harshitkalra03/autonomous_warehouse_surveillance/Demo/Screenshot from 2025-11-26 17-15-10.png

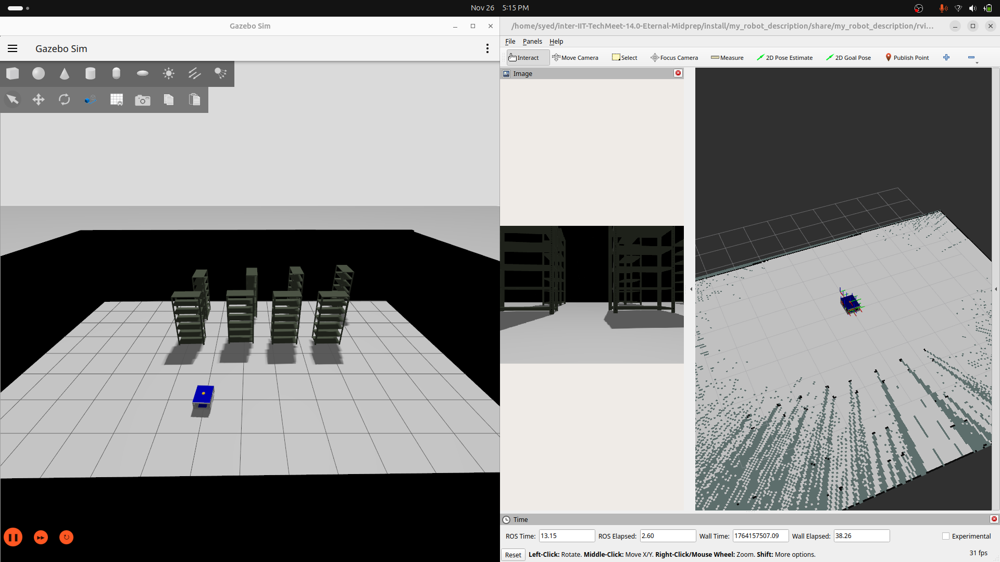
Demo/Screenshot from 2025-11-26 17-15-10.png
