harshitkalra03/autonomous_warehouse_surveillance/Demo/Screenshot from 2025-11-26 17-16-41.png

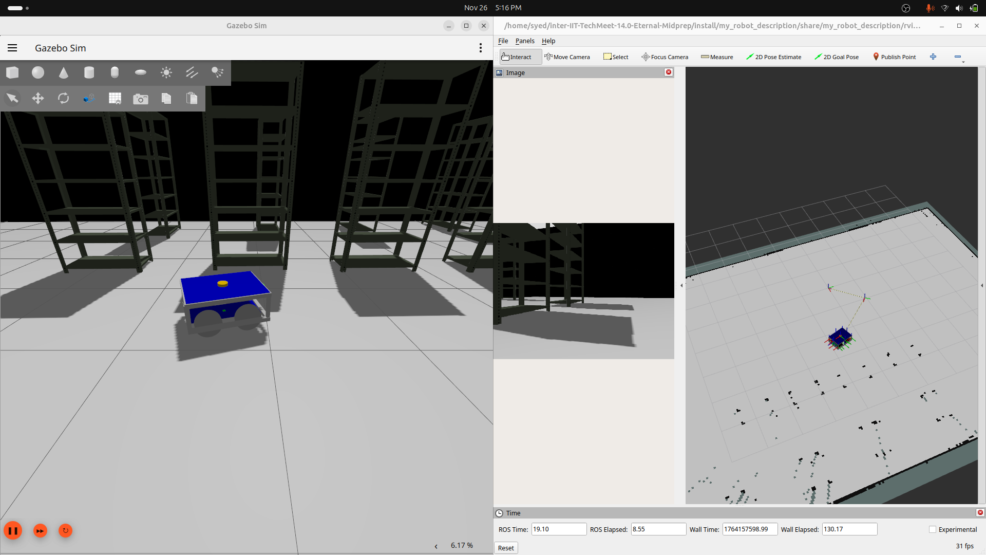
Demo/Screenshot from 2025-11-26 17-16-41.png
