harshitkalra03/autonomous_warehouse_surveillance/Electrical Schematics/Emergency Stop Circuit (Hard Wired).png

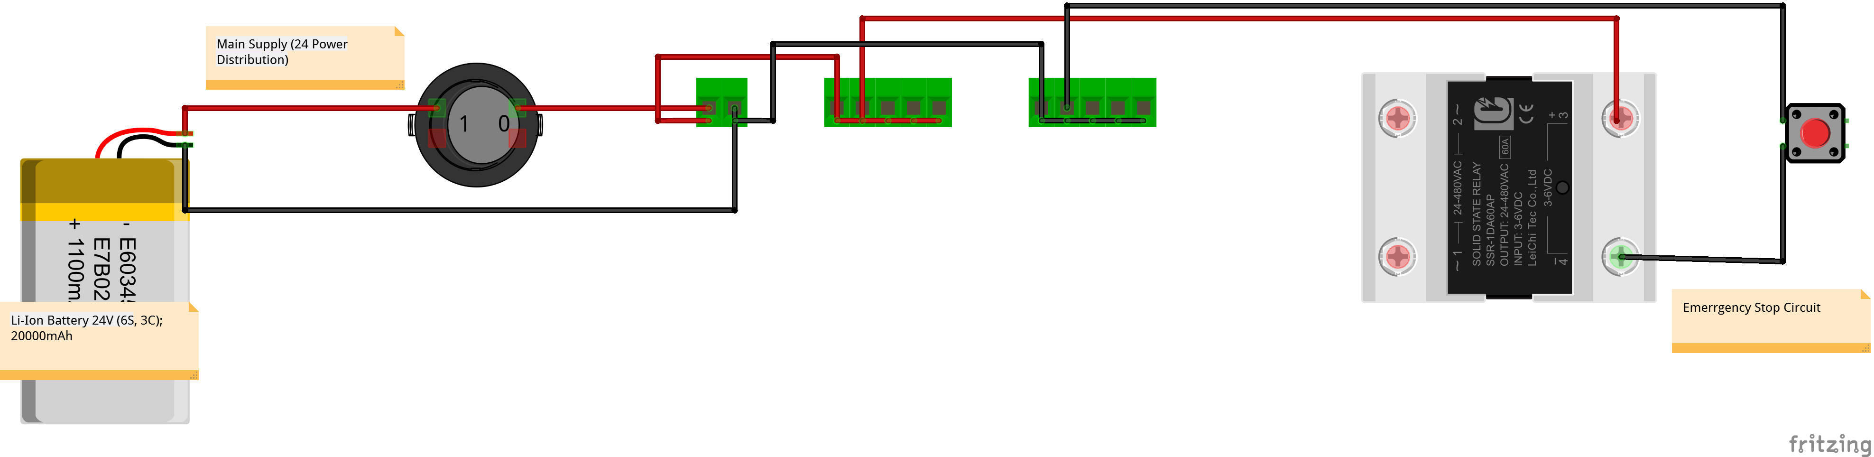
Electrical Schematics/Emergency Stop Circuit (Hard Wired).png
