harshitkalra03/autonomous_warehouse_surveillance/hardware/bot base.SLDASM

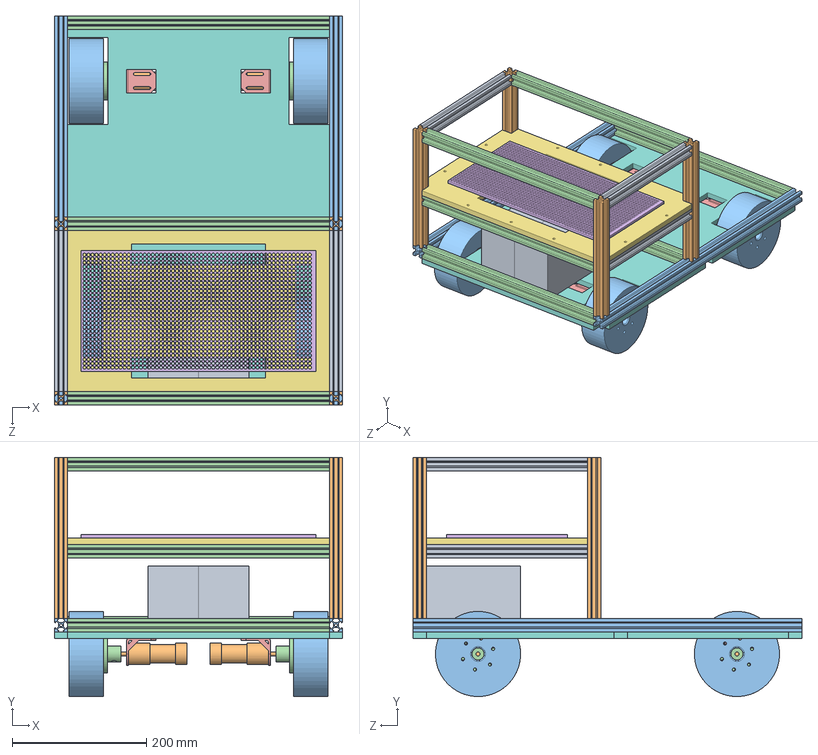
[picture p11: CAD file, 2026-06-30]
hardware/bot base.SLDASM
430.0 x 356.5 x 580.0 mm
layer 1 width x 7
layer 1 length x 2
layer 1 hight x 4
layer 2 length x 4
Sunboard
Vertical_Sunboard
Perfboard
Motor Mount_IG32 x 4
Wheel Mount_6mm x 4
Wheels x 4
IG32 Motor x 4
Battery x 2
