harshitkalra03/autonomous_warehouse_surveillance/hardware/bot base/wheel+motor.SLDASM

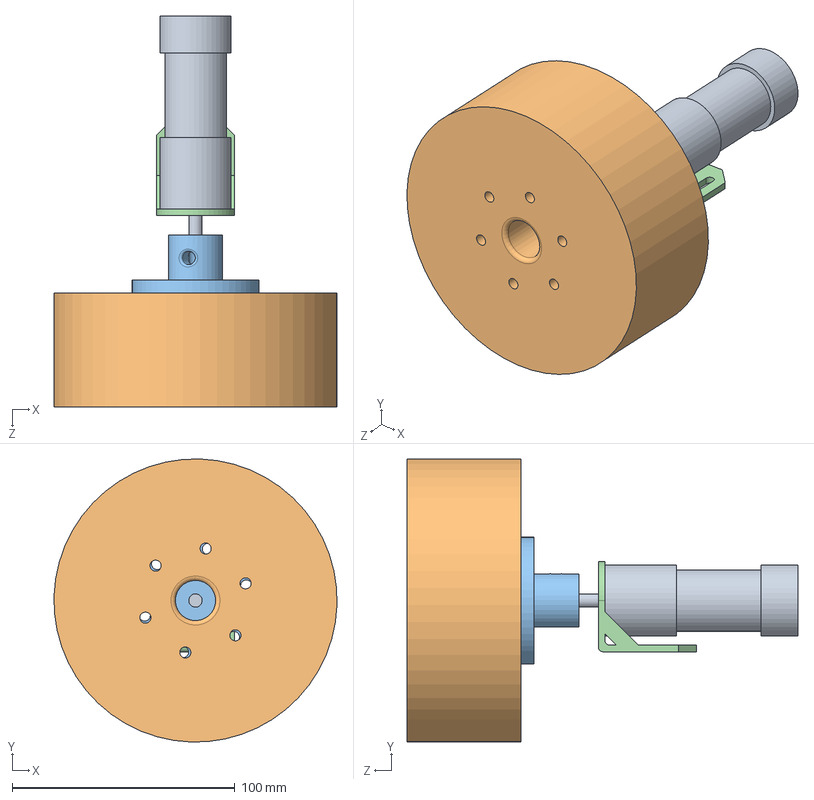
[picture p12: CAD file, 2026-06-30]
hardware/bot base/wheel+motor.SLDASM
126.9 x 126.9 x 175.3 mm
Motor Mount_IG32
Wheel Mount_6mm
Wheels
IG32 Motor
