harshitkalra03/autonomous_warehouse_surveillance/hardware/lifting mechanisum/mechanisum base/mechanisum base.SLDASM

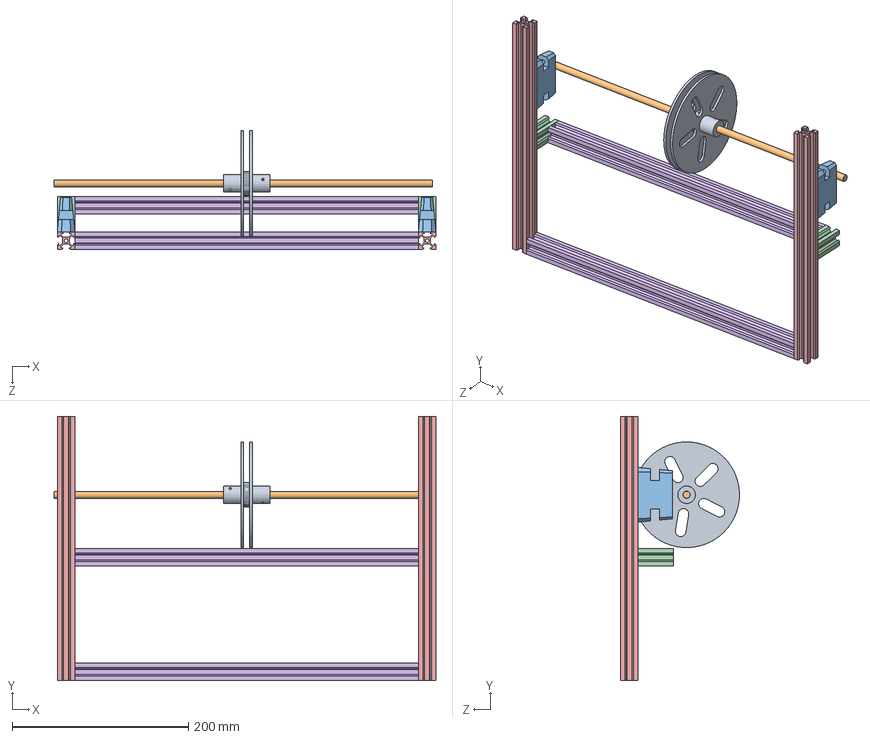
[picture p13: CAD file, 2026-06-30]
hardware/lifting mechanisum/mechanisum base/mechanisum base.SLDASM
433.7 x 300.0 x 135.0 mm
Aluminium Profile for width x 2
Aluminium Profile for length x 2
Aluminium Profile for hight x 2
bearing stand x 2
8mm shaft rod
winder side 1 x 2
