harshitkalra03/autonomous_warehouse_surveillance/hardware/lifting mechanisum/mechanisum/new camera mount.SLDASM

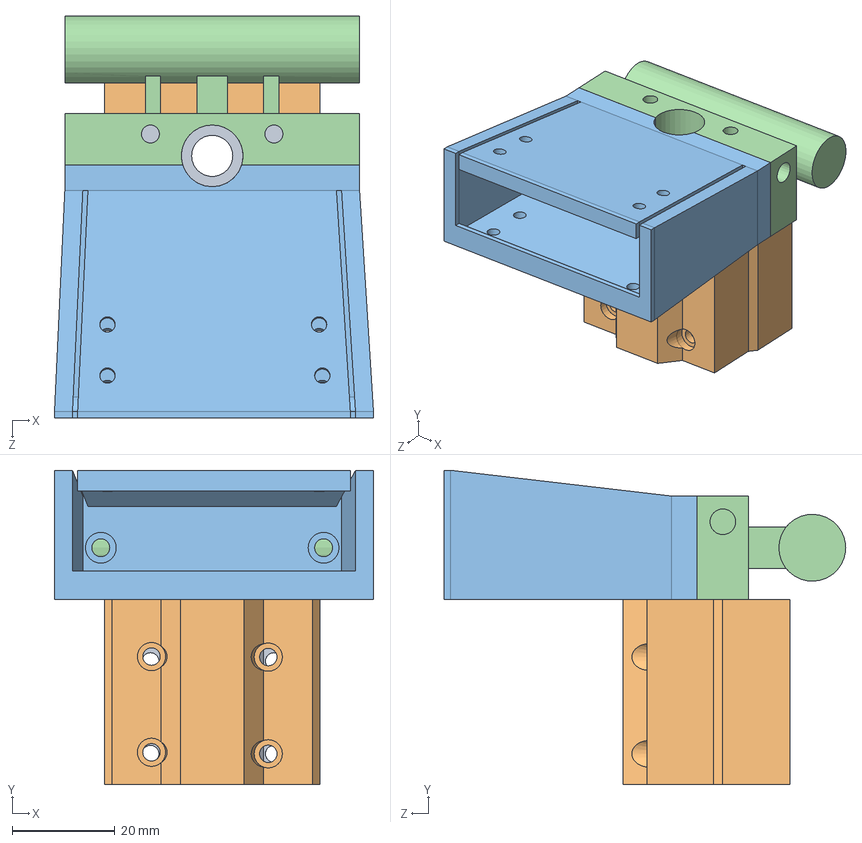
[picture p14: CAD file, 2026-06-30]
hardware/lifting mechanisum/mechanisum/new camera mount.SLDASM
62.0 x 61.1 x 78.0 mm
camera mount new part 2
camera mount new part 1
camera mount new part 3
vertical bearing
