harshitkalra03/autonomous_warehouse_surveillance/hardware/bot base/base/Sunboard.SLDPRT

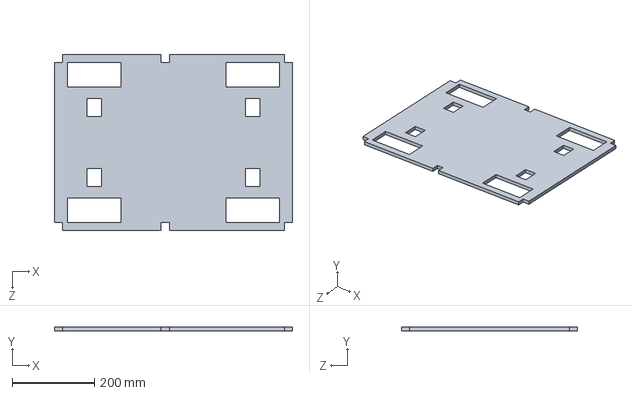
[picture p15: CAD file, 2026-06-30]
hardware/bot base/base/Sunboard.SLDPRT
580.0 x 10.0 x 430.0 mm
