harshitkalra03/autonomous_warehouse_surveillance/hardware/bot base/Battery.SLDPRT

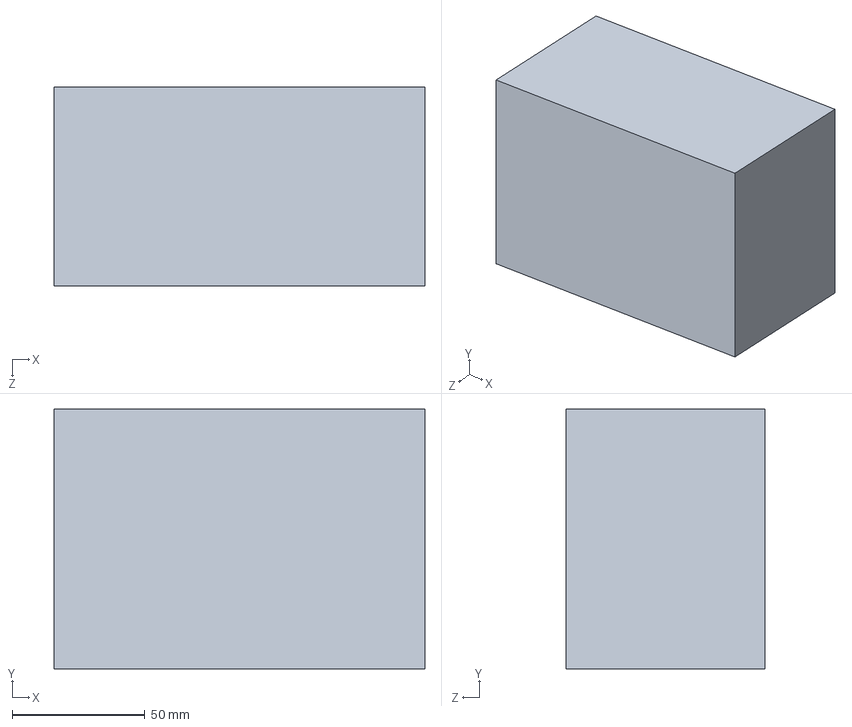
[picture p16: CAD file, 2026-06-30]
hardware/bot base/Battery.SLDPRT
140.0 x 98.0 x 75.0 mm
