harshitkalra03/autonomous_warehouse_surveillance/hardware/bot base/driving system/IG32 Motor.SLDPRT

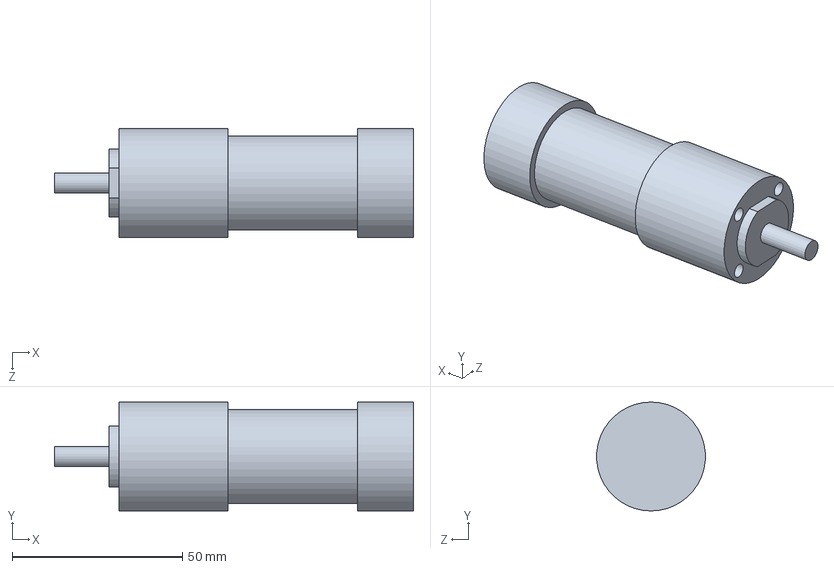
[picture p17: CAD file, 2026-06-30]
hardware/bot base/driving system/IG32 Motor.SLDPRT
105.5 x 32.0 x 31.9 mm
