harshitkalra03/autonomous_warehouse_surveillance/hardware/bot base/extrusion profile/layer 1 hight.SLDPRT

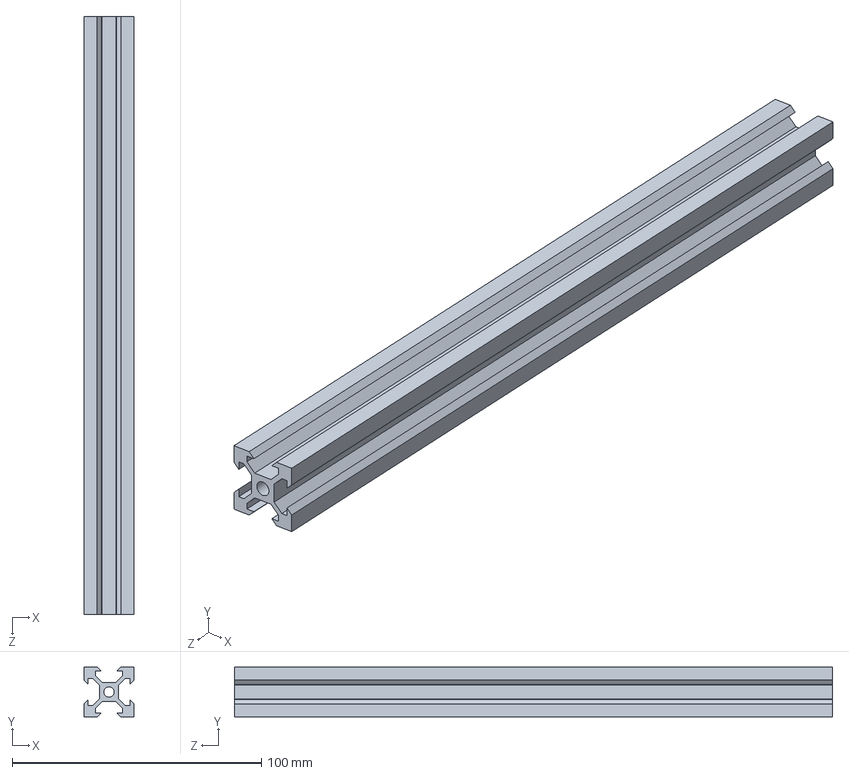
[picture p18: CAD file, 2026-06-30]
hardware/bot base/extrusion profile/layer 1 hight.SLDPRT
20.0 x 20.0 x 240.0 mm
