harshitkalra03/autonomous_warehouse_surveillance/hardware/lifting mechanisum/mechanisum base/bearing stand.SLDPRT

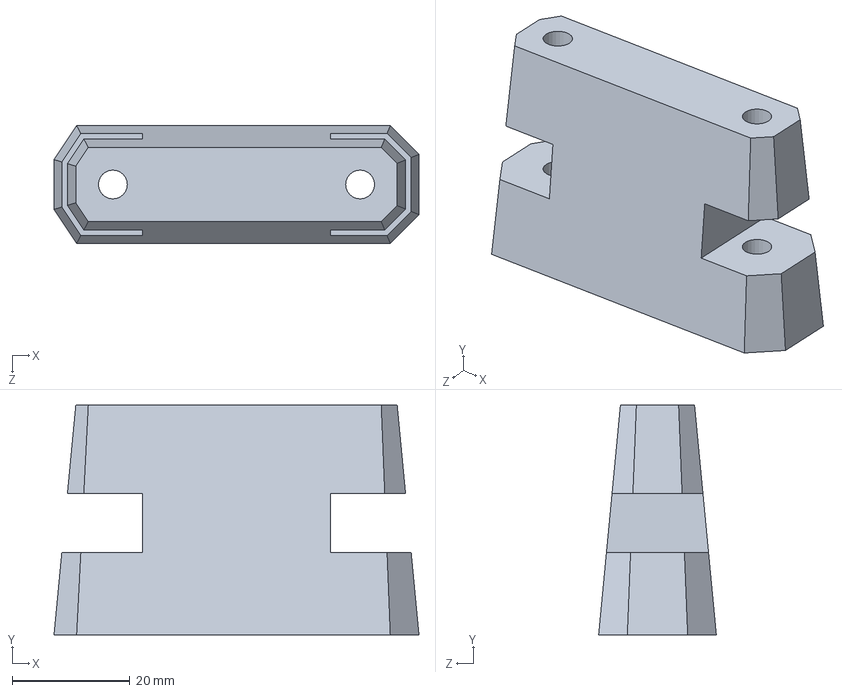
[picture p19: CAD file, 2026-06-30]
hardware/lifting mechanisum/mechanisum base/bearing stand.SLDPRT
62.0 x 39.0 x 20.0 mm
