harshitkalra03/autonomous_warehouse_surveillance/hardware/lifting mechanisum/mechanisum base/extrusion frame/Aluminium Profile for hight.SLDPRT

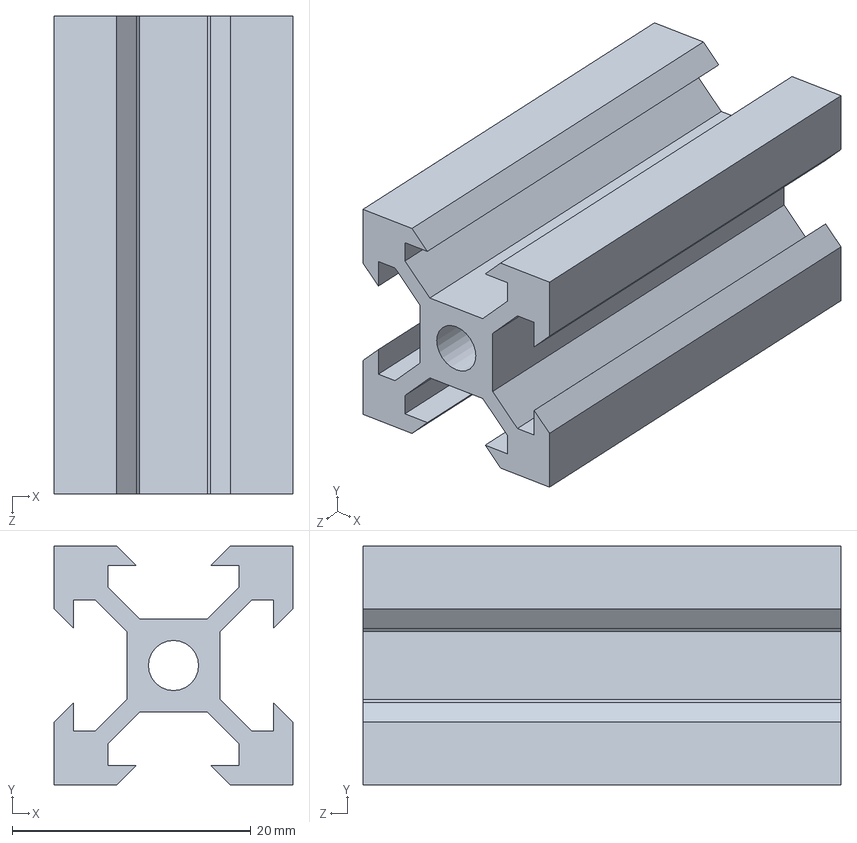
[picture p20: CAD file, 2026-06-30]
hardware/lifting mechanisum/mechanisum base/extrusion frame/Aluminium Profile for hight.SLDPRT
20.0 x 20.0 x 40.0 mm
