harshitkalra03/autonomous_warehouse_surveillance/hardware/lifting mechanisum/mechanisum/camera mount/camera mount new part 2.SLDPRT

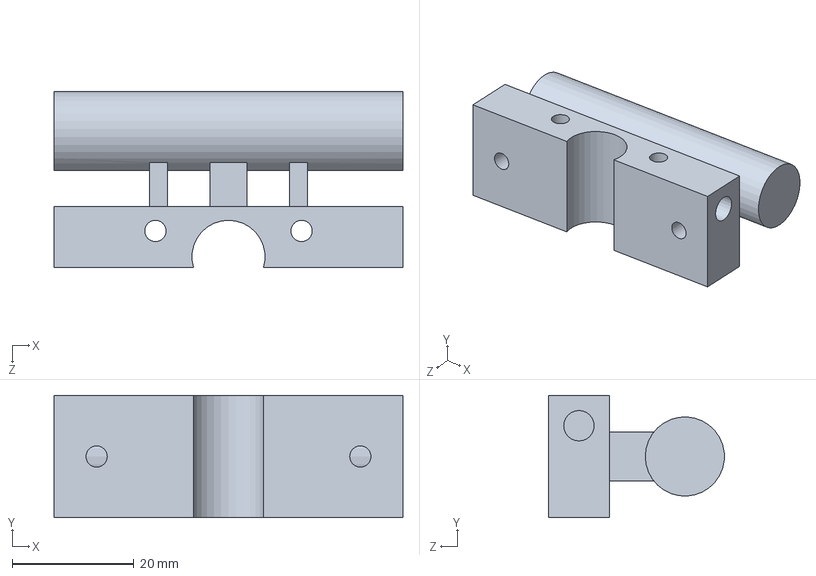
[picture p21: CAD file, 2026-06-30]
hardware/lifting mechanisum/mechanisum/camera mount/camera mount new part 2.SLDPRT
57.3 x 20.1 x 28.9 mm
