harshitkalra03/autonomous_warehouse_surveillance/hardware/lifting mechanisum/mechanisum/glider/bearing.SLDPRT

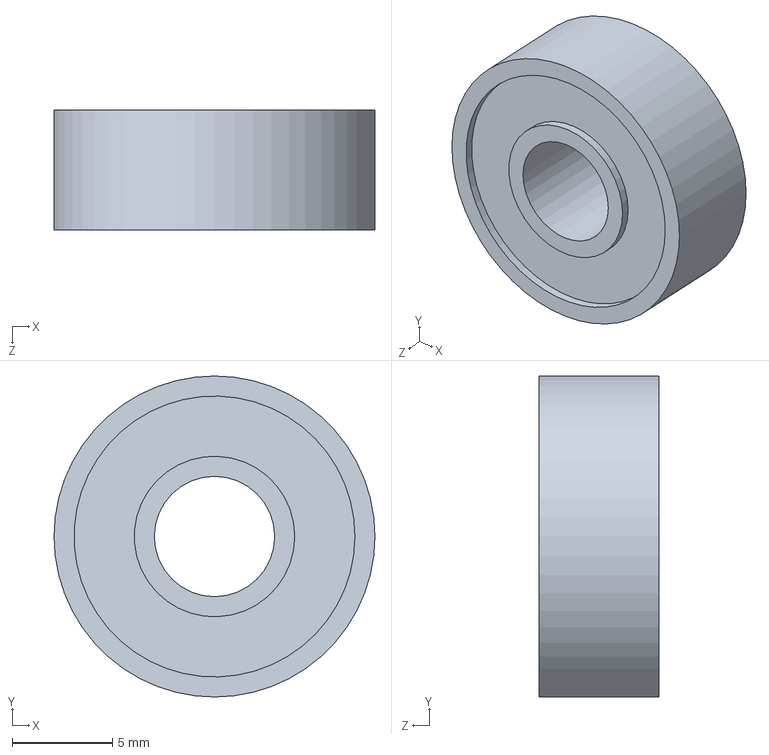
[picture p22: CAD file, 2026-06-30]
hardware/lifting mechanisum/mechanisum/glider/bearing.SLDPRT
16.0 x 16.0 x 6.00 mm
