harshitkalra03/autonomous_warehouse_surveillance/hardware/lifting mechanisum/mechanisum/rail setup/8mm crome plated rod.SLDPRT

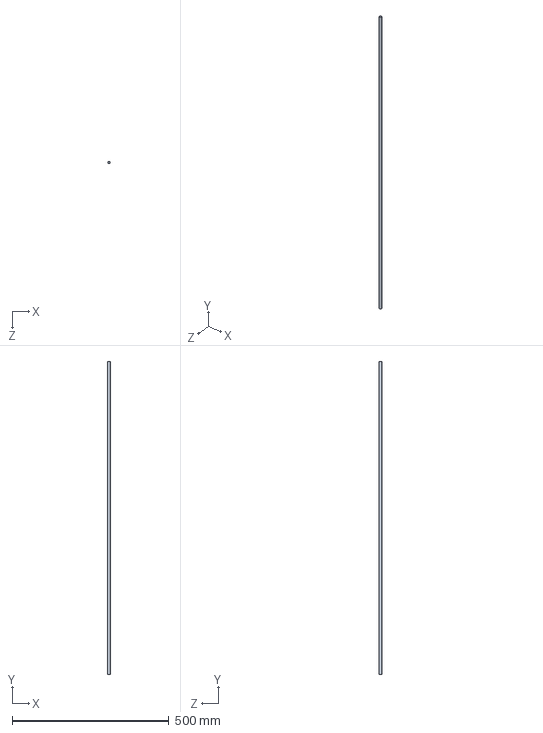
[picture p23: CAD file, 2026-06-30]
hardware/lifting mechanisum/mechanisum/rail setup/8mm crome plated rod.SLDPRT
8.00 x 1000.0 x 8.00 mm
