harshitkalra03/autonomous_warehouse_surveillance/hardware/mechanisum support.SLDPRT

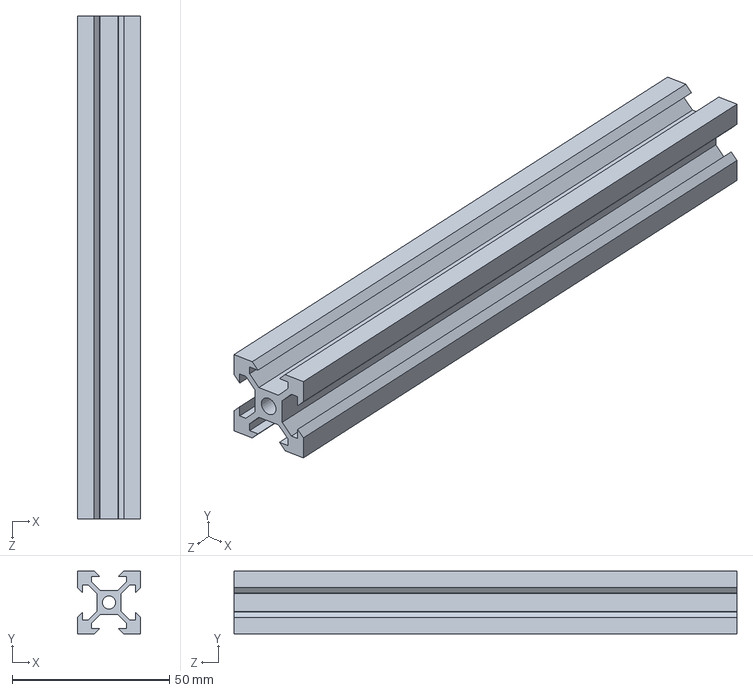
[picture p24: CAD file, 2026-06-30]
hardware/mechanisum support.SLDPRT
20.0 x 20.0 x 160.0 mm
