harshitkalra03/autonomous_warehouse_surveillance/hardware/bot base/base/Vertical_Sunboard.SLDPRT

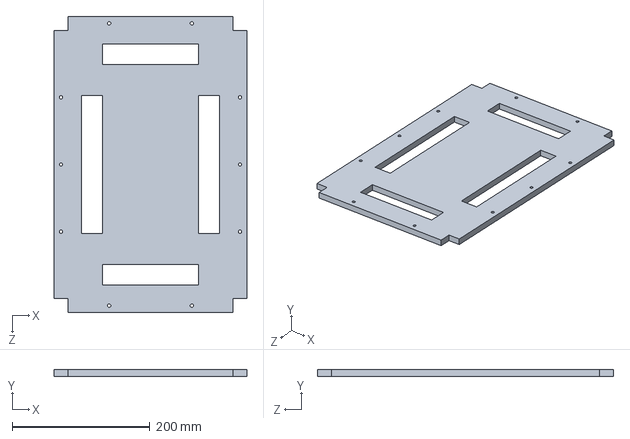
[picture p25: CAD file, 2026-06-30]
hardware/bot base/base/Vertical_Sunboard.SLDPRT
280.0 x 10.0 x 430.0 mm
