harshitkalra03/autonomous_warehouse_surveillance/hardware/bot base/driving system/Wheels.SLDPRT

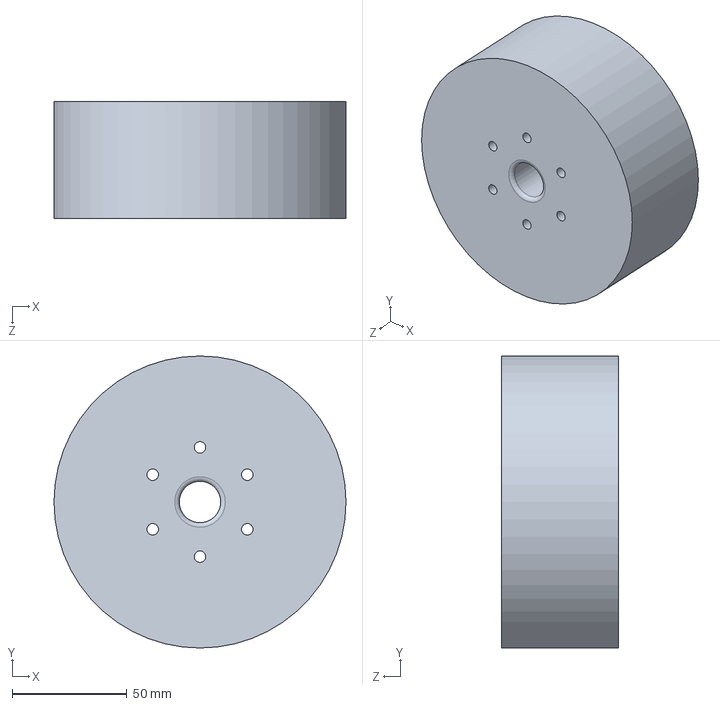
[picture p26: CAD file, 2026-06-30]
hardware/bot base/driving system/Wheels.SLDPRT
127.0 x 127.0 x 51.0 mm
