harshitkalra03/autonomous_warehouse_surveillance/hardware/bot base/extrusion profile/layer 1 width.SLDPRT

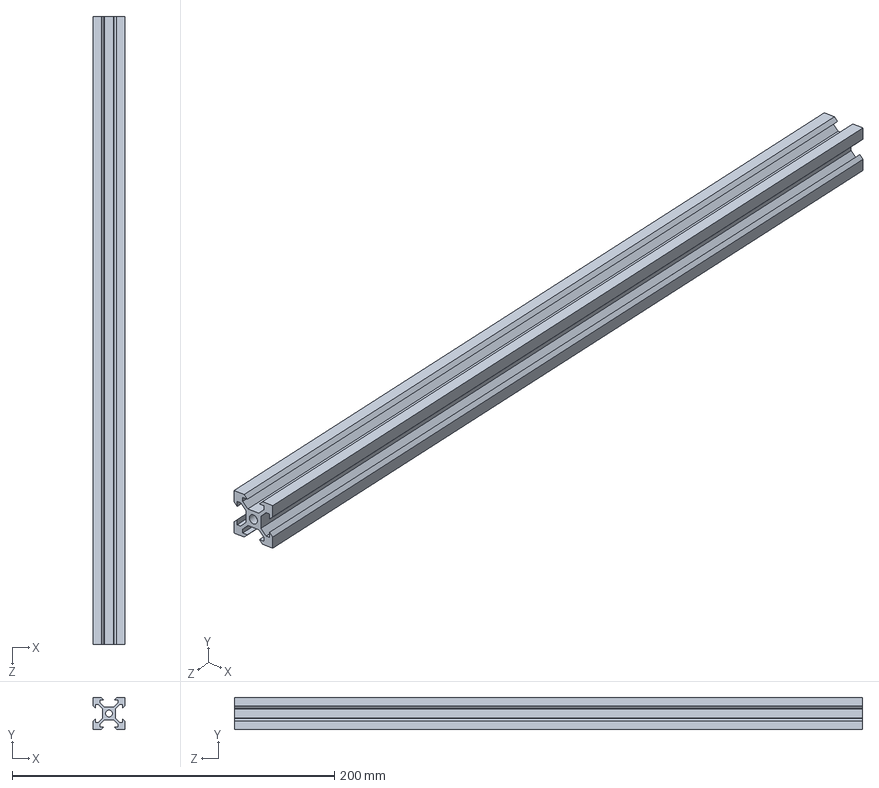
[picture p27: CAD file, 2026-06-30]
hardware/bot base/extrusion profile/layer 1 width.SLDPRT
20.0 x 20.0 x 390.0 mm
