harshitkalra03/autonomous_warehouse_surveillance/hardware/lifting mechanisum/mechanisum/camera mount/camera mount new part 3.SLDPRT

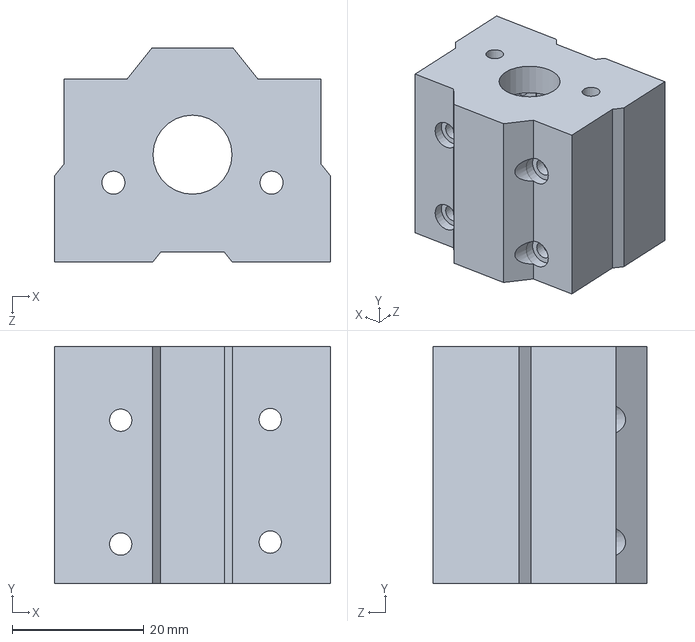
[picture p28: CAD file, 2026-06-30]
hardware/lifting mechanisum/mechanisum/camera mount/camera mount new part 3.SLDPRT
41.9 x 36.0 x 32.5 mm
