harshitkalra03/autonomous_warehouse_surveillance/hardware/lifting mechanisum/mechanisum/rail setup/rod Tube R8 holder.SLDPRT

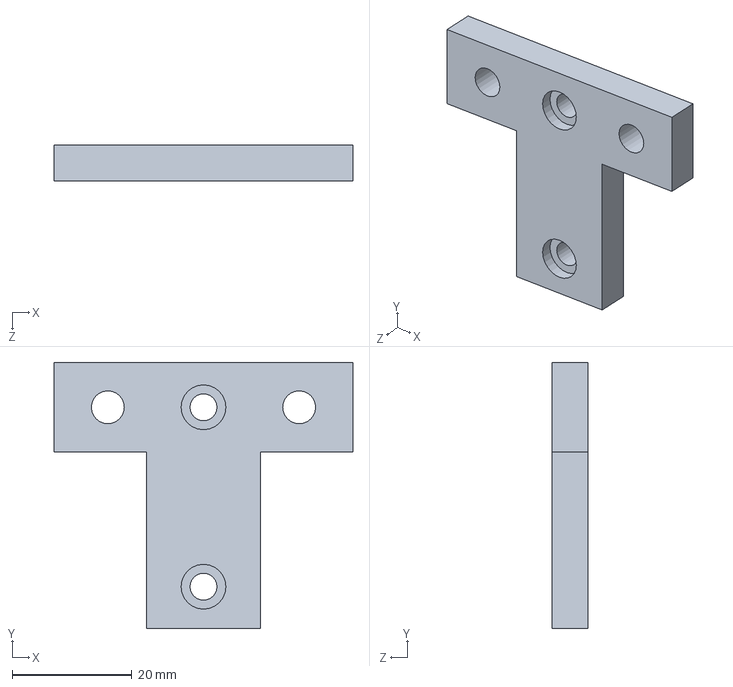
[picture p29: CAD file, 2026-06-30]
hardware/lifting mechanisum/mechanisum/rail setup/rod Tube R8 holder.SLDPRT
50.0 x 44.5 x 6.00 mm
