harshitkalra03/autonomous_warehouse_surveillance/hardware/bot base/base/Perfboard.SLDPRT

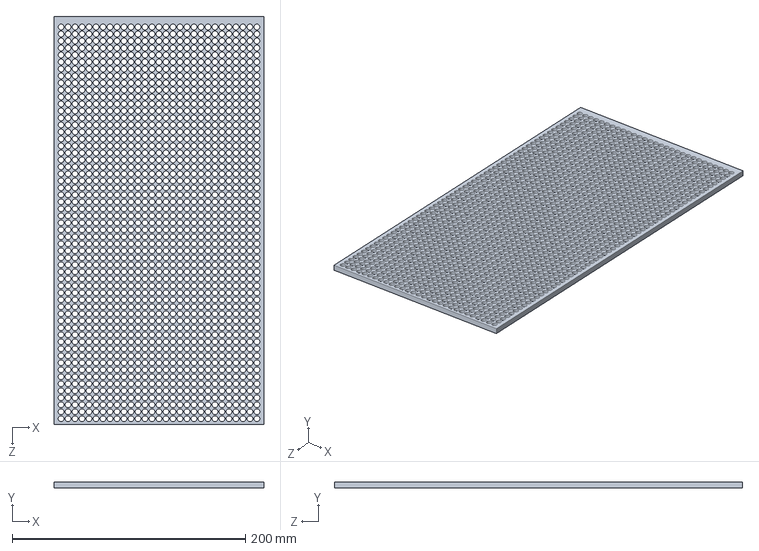
[picture p30: CAD file, 2026-06-30]
hardware/bot base/base/Perfboard.SLDPRT
180.0 x 5.00 x 350.0 mm
