harshitkalra03/autonomous_warehouse_surveillance/hardware/bot base/driving system/Motor Mount_IG32.SLDPRT

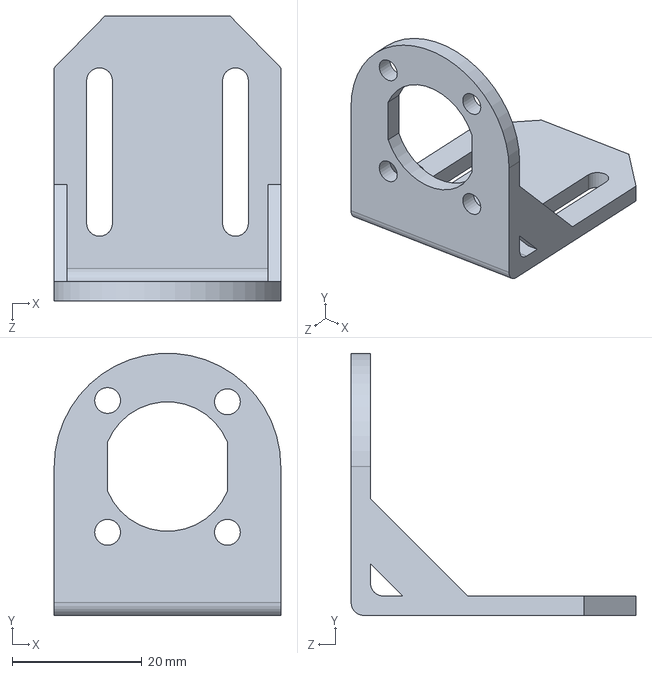
[picture p31: CAD file, 2026-06-30]
hardware/bot base/driving system/Motor Mount_IG32.SLDPRT
35.0 x 40.5 x 44.0 mm
