harshitkalra03/autonomous_warehouse_surveillance/hardware/lifting mechanisum/mechanisum base/extrusion frame/Aluminium Profile for length.SLDPRT

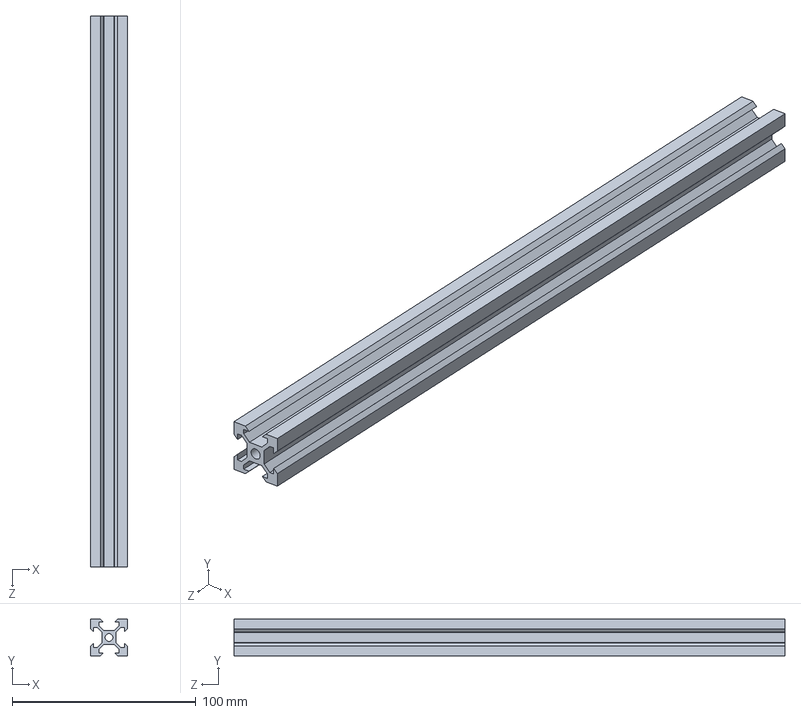
[picture p32: CAD file, 2026-06-30]
hardware/lifting mechanisum/mechanisum base/extrusion frame/Aluminium Profile for length.SLDPRT
20.0 x 20.0 x 300.0 mm
