harshitkalra03/autonomous_warehouse_surveillance/hardware/lifting mechanisum/mechanisum/Aluminium Profile for vertical part.SLDPRT

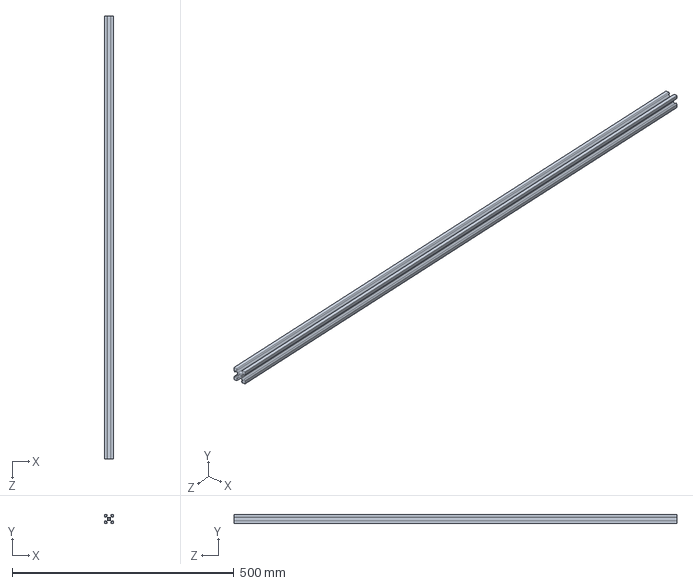
[picture p33: CAD file, 2026-06-30]
hardware/lifting mechanisum/mechanisum/Aluminium Profile for vertical part.SLDPRT
20.0 x 20.0 x 1000.0 mm
