harshitkalra03/autonomous_warehouse_surveillance/hardware/lifting mechanisum/mechanisum/camera mount/vertical bearing.SLDPRT

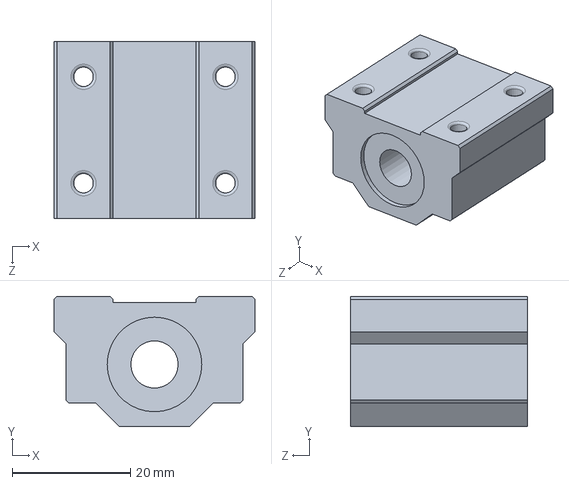
[picture p34: CAD file, 2026-06-30]
hardware/lifting mechanisum/mechanisum/camera mount/vertical bearing.SLDPRT
34.0 x 22.0 x 30.0 mm
