harshitkalra03/autonomous_warehouse_surveillance/hardware/lifting mechanisum/mechanisum/rail setup/8mm shaft rod.SLDPRT

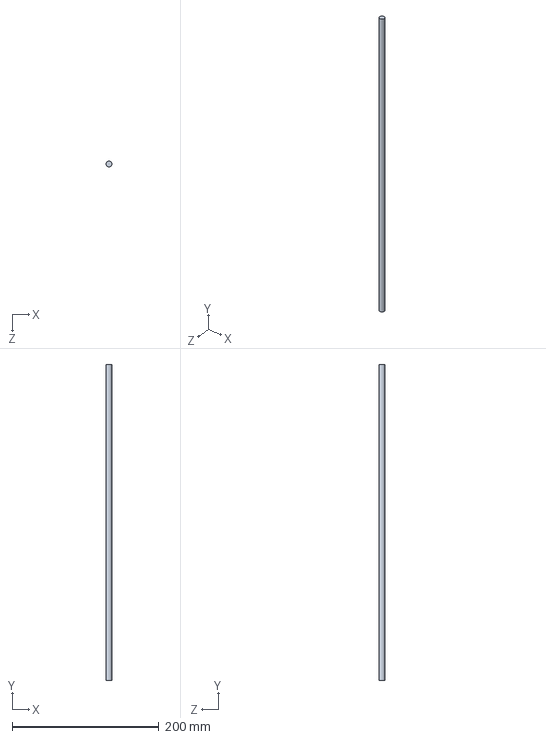
[picture p35: CAD file, 2026-06-30]
hardware/lifting mechanisum/mechanisum/rail setup/8mm shaft rod.SLDPRT
8.00 x 430.0 x 8.00 mm
