harshitkalra03/autonomous_warehouse_surveillance/hardware/bot base/driving system/Wheel Mount_6mm.SLDPRT

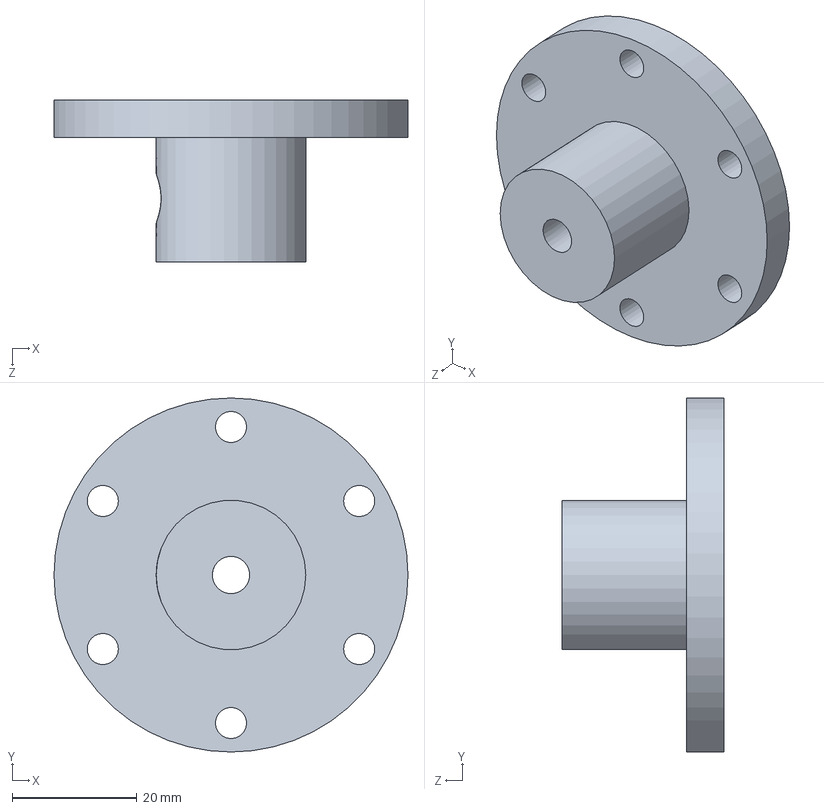
[picture p36: CAD file, 2026-06-30]
hardware/bot base/driving system/Wheel Mount_6mm.SLDPRT
56.8 x 56.8 x 26.0 mm
