harshitkalra03/autonomous_warehouse_surveillance/hardware/bot base/extrusion profile/layer 1 length.SLDPRT

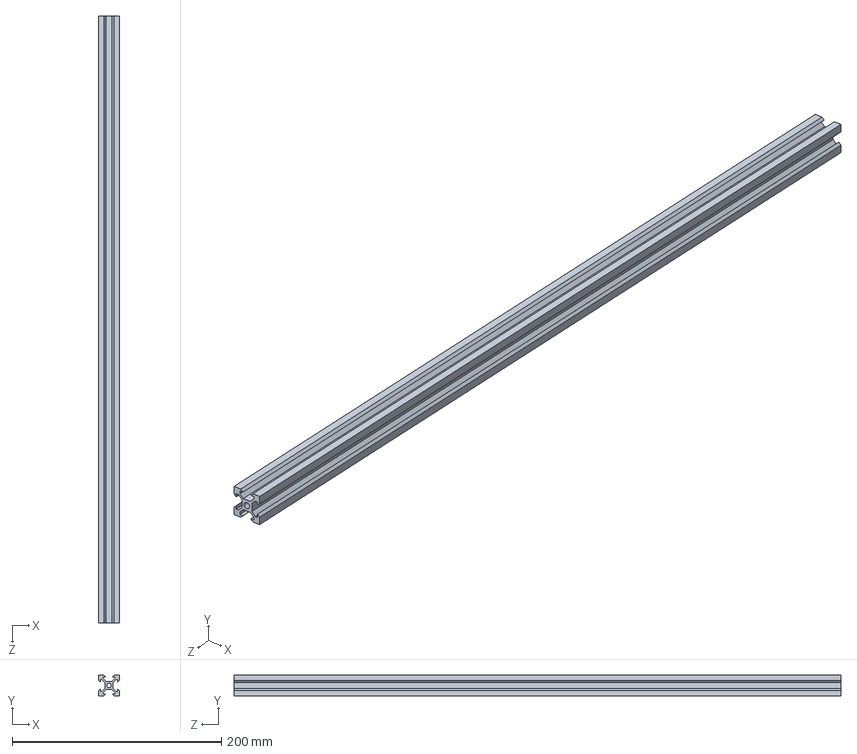
[picture p37: CAD file, 2026-06-30]
hardware/bot base/extrusion profile/layer 1 length.SLDPRT
20.0 x 20.0 x 580.0 mm
