harshitkalra03/autonomous_warehouse_surveillance/hardware/corner bracket.SLDPRT

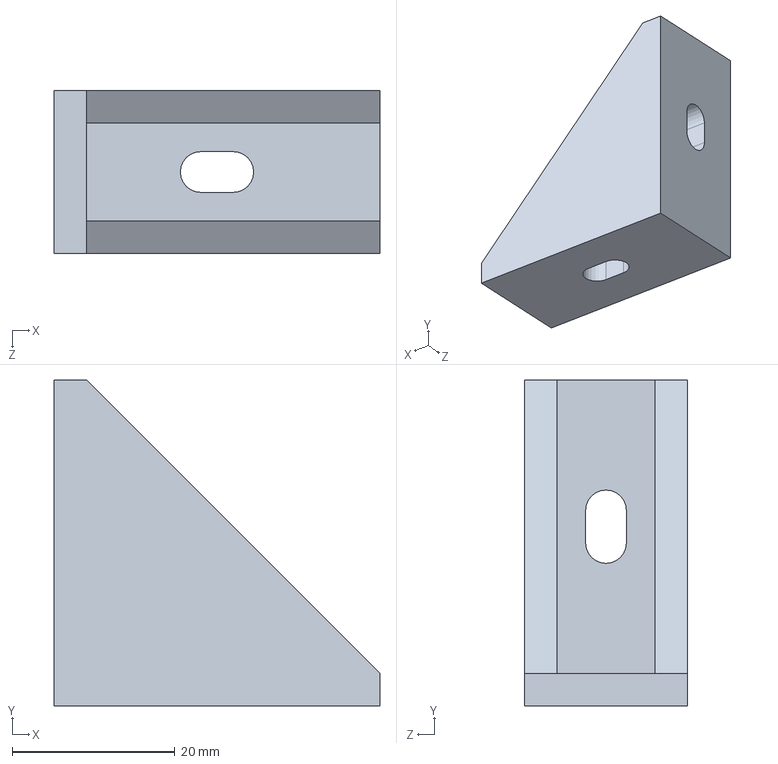
[picture p38: CAD file, 2026-06-30]
hardware/corner bracket.SLDPRT
40.0 x 40.0 x 20.0 mm
