harshitkalra03/autonomous_warehouse_surveillance/hardware/lifting mechanisum/mechanisum base/winder side 1.SLDPRT

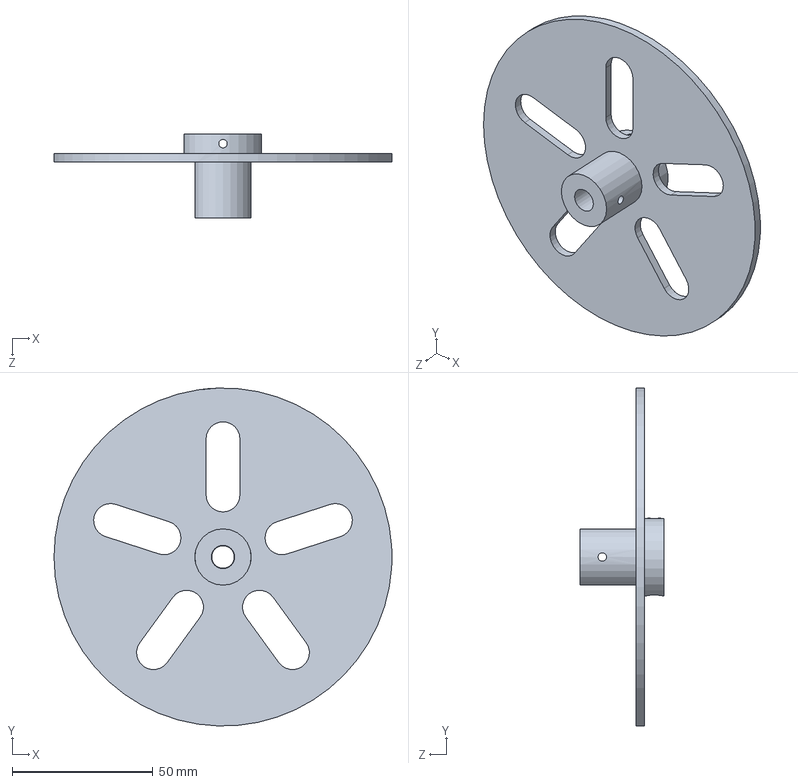
[picture p39: CAD file, 2026-06-30]
hardware/lifting mechanisum/mechanisum base/winder side 1.SLDPRT
120.0 x 119.9 x 30.0 mm
