harshitkalra03/autonomous_warehouse_surveillance/hardware/lifting mechanisum/mechanisum/camera mount/camera mount new part 1.SLDPRT

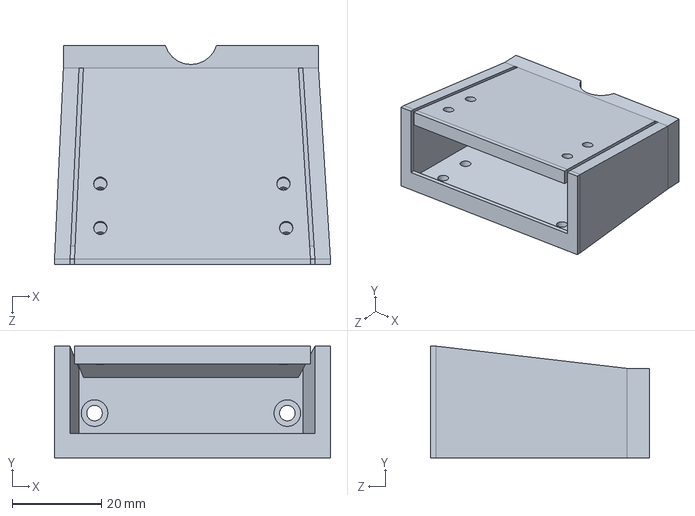
[picture p40: CAD file, 2026-06-30]
hardware/lifting mechanisum/mechanisum/camera mount/camera mount new part 1.SLDPRT
62.0 x 25.1 x 49.1 mm
