harshitkalra03/autonomous_warehouse_surveillance/hardware/lifting mechanisum/mechanisum/glider/Delrin V Wheel.SLDPRT

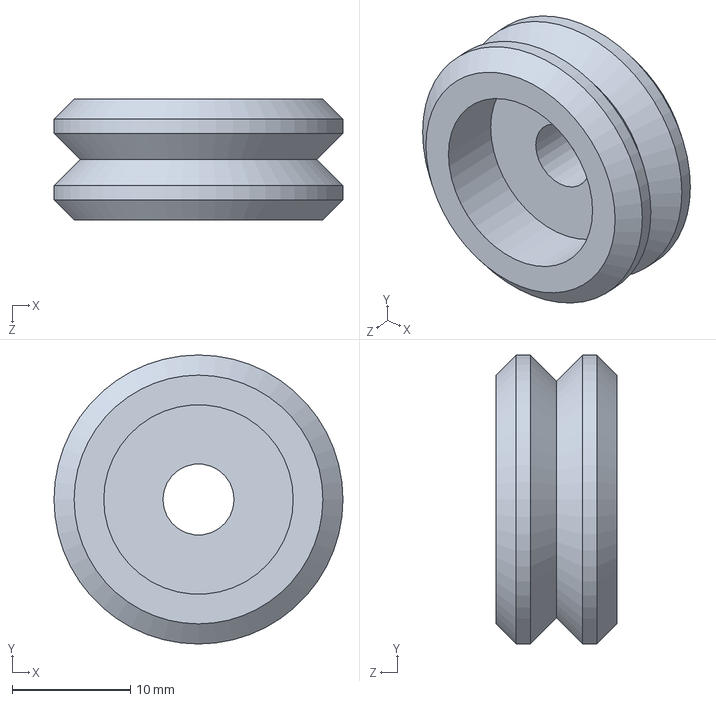
[picture p41: CAD file, 2026-06-30]
hardware/lifting mechanisum/mechanisum/glider/Delrin V Wheel.SLDPRT
24.4 x 24.4 x 10.2 mm
