harshitkalra03/autonomous_warehouse_surveillance/hardware/lifting mechanisum/mechanisum/rail setup/rod Tube R8.SLDPRT

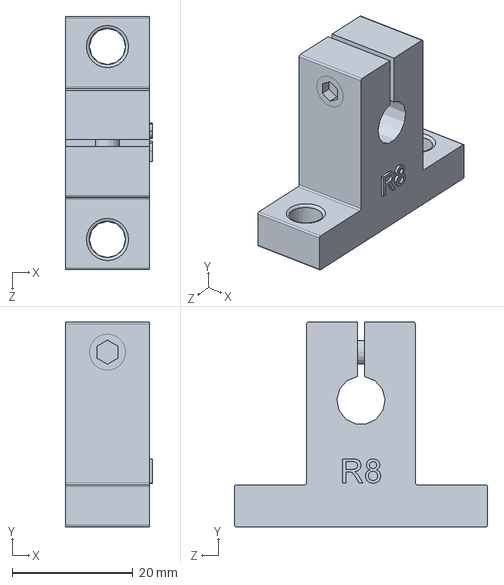
[picture p42: CAD file, 2026-06-30]
hardware/lifting mechanisum/mechanisum/rail setup/rod Tube R8.SLDPRT
14.5 x 34.0 x 42.0 mm
