harshitkalra03/autonomous_warehouse_surveillance/hardware/lifting mechanisum/mechanisum/glider/upgraded minirollar plate.SLDPRT

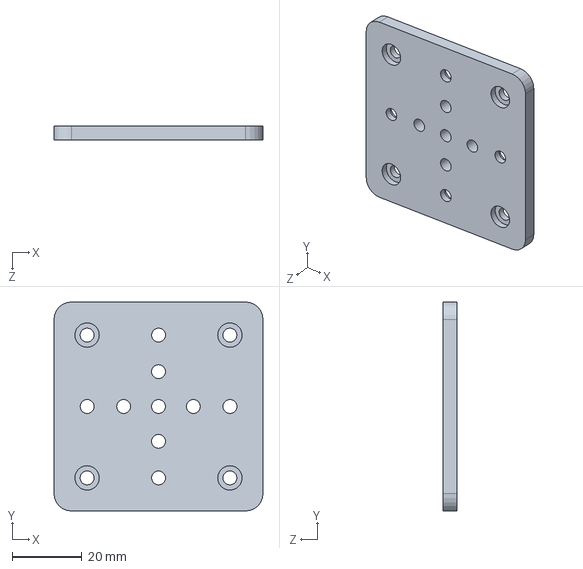
[picture p43: CAD file, 2026-06-30]
hardware/lifting mechanisum/mechanisum/glider/upgraded minirollar plate.SLDPRT
60.0 x 60.0 x 4.00 mm
