harshitkalra03/autonomous_warehouse_surveillance/hardware/lifting mechanisum/mechanisum/mini roller.SLDASM

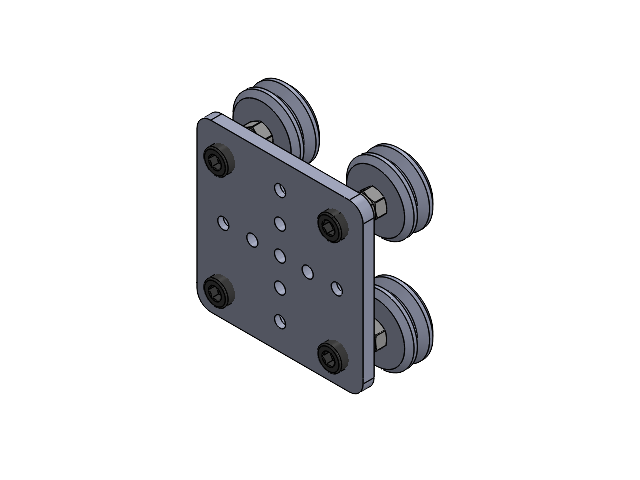
[picture p44: CAD file, 2026-06-30]
hardware/lifting mechanisum/mechanisum/mini roller.SLDASM
upgraded minirollar plate
M5x25mm l key bolt x 4
M5 nut x 12
Delrin V Wheel x 4
bearing x 4
