harshitkalra03/autonomous_warehouse_surveillance/hardware/lifting mechanisum/mechanisum base/KP08 Flange Bearing.SLDASM

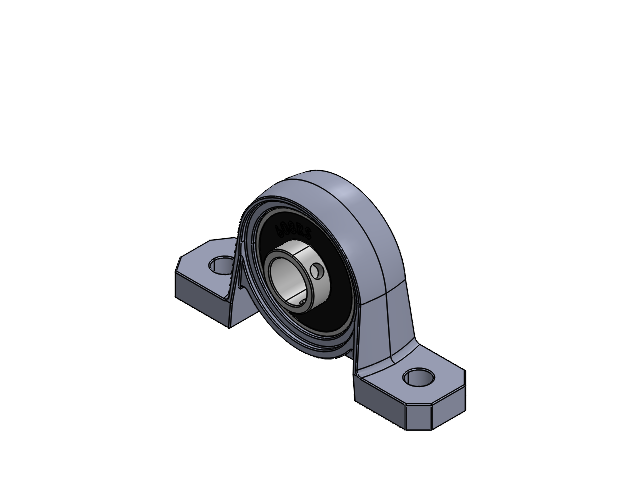
[picture p45: CAD file, 2026-06-30]
hardware/lifting mechanisum/mechanisum base/KP08 Flange Bearing.SLDASM
KP08_1.STEP
608RS.STEP
