harshitkalra03/autonomous_warehouse_surveillance/hardware/lifting mechanisum/mechanisum/glider/rollar assembly.SLDASM

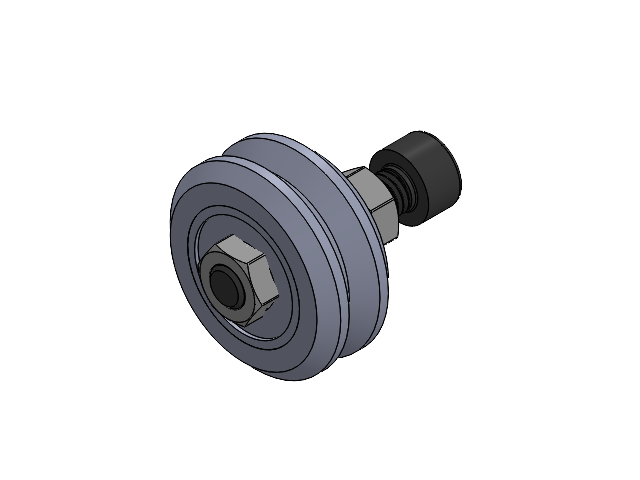
[picture p46: CAD file, 2026-06-30]
hardware/lifting mechanisum/mechanisum/glider/rollar assembly.SLDASM
M5x25mm l key bolt
M5 nut x 3
Delrin V Wheel
bearing
