harshitkalra03/autonomous_warehouse_surveillance/hardware/lifting mechanisum/mechanisum/rollar + 2020.SLDASM

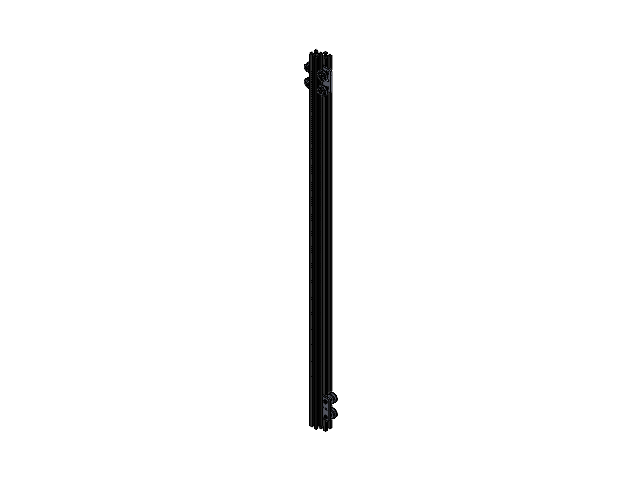
[picture p47: CAD file, 2026-06-30]
hardware/lifting mechanisum/mechanisum/rollar + 2020.SLDASM
Aluminium Profile for vertical part x 2
upgraded minirollar plate x 2
M5x25mm l key bolt x 8
M5 nut x 24
Delrin V Wheel x 8
bearing x 8
