harshitkalra03/autonomous_warehouse_surveillance/hardware/lifting mechanisum.SLDASM

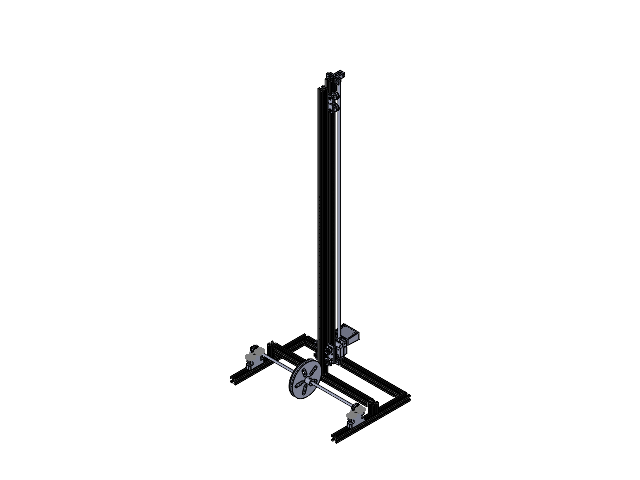
[picture p48: CAD file, 2026-06-30]
hardware/lifting mechanisum.SLDASM
Aluminium Profile for width x 2
Aluminium Profile for length x 2
Aluminium Profile for hight x 2
bearing stand x 2
KP08_1.STEP x 2
608RS.STEP x 2
8mm shaft rod
winder side 1 x 2
Aluminium Profile for vertical part x 2
upgraded minirollar plate x 2
M5x25mm l key bolt x 8
M5 nut x 24
Delrin V Wheel x 8
bearing x 8
rod Tube R8 x 2
8mm crome plated rod
rod Tube R8 holder x 2
camera mount new part 2
camera mount new part 1
camera mount new part 3
vertical bearing
