harshitkalra03/autonomous_warehouse_surveillance/(list of files, cad)

Other CAD files:
hardware/lifting mechanisum/mechanisum base/extrusion frame/Aluminium Profile for width.SLDPRT
hardware/bot base/extrusion profile/layer 2 length.SLDPRT
hardware/lifting mechanisum/mechanisum/glider/M5 nut.SLDPRT
hardware/lifting mechanisum/mechanisum/glider/M5x25mm l key bolt.SLDPRT
