harshitkalra03/autonomous_warehouse_surveillance/(commit log)

2025-12-04 test commit
    [common_properties.xacro, mobile_base.ros2_control.xacro, mobile_base.xacro, my_robot.urdf.xacro, my_robot_controllers.yaml, stepper_motor_params.yaml]
2025-12-05 fixed lidar tf, changed nav2 params and lidar angle range
2025-12-05 changed ports name
    [mobile_base.ros2_control.xacro]
2025-12-05 added esp32 code
2025-12-05 removed demo socket
2025-12-05 initialized web socket from raspberry pi
2025-12-06 stepper fix
    [stepper_motor_params.yaml]
2025-12-10 fixed lidar data orientation
    [mobile_base.xacro]
2025-12-12 fixed RR encoder count
    [mobile_base.ros2_control.xacro]
2026-06-30 Bot base Files
    [Battery.SLDPRT, IG32 Motor.SLDPRT, Motor Mount_IG32.SLDPRT, Perfboard.SLDPRT, Sunboard.SLDPRT, Vertical_Sunboard.SLDPRT, Wheel Mount_6mm.SLDPRT, Wheels.SLDPRT]
2026-06-30 Lifting Mechanism Files
    [8mm crome plated rod.SLDPRT, 8mm shaft rod.SLDPRT, Aluminium Profile for hight.SLDPRT, Aluminium Profile for length.SLDPRT, Aluminium Profile for vertical part.SLDPRT, Aluminium Profile for width.SLDPRT, Delrin V Wheel.SLDPRT, KP08 Flange Bearing.SLDASM]
2026-06-30 Added Assemblies & Drawings of the bot
    [bot base.SLDASM, corner bracket.SLDPRT, lifting mechanisum.SLDASM, mechanisum support.SLDPRT]
2026-06-30 Added demo videos, and Electrical Schematics
2026-06-30 Updated the repo with project report, BOM, and hardware testing videos
    [BOM_Itemized.csv]
2026-06-30 Enhance README with detailed project information
    Expanded project description and added detailed sections on repository structure, software, hardware, electrical schematics, BOM, project report, demonstration, Git LFS, and getting started instructions.
